stimey-mn/STM32-MetalDetector/README.md

# STM32-MetalDetector
STM32L412KB based Pulse Induction Metal Detector

Features:
* Hand solder friendly SMT parts (MCU is 0.8mm pitch LQFP, all others are SOIC and/or through hole parts.)
* STM32L4 series has 5 MSPS 12 bit ADC and ADC triggers to pulse timer
* Boost converter creates high voltage coil voltage
* Display of PI decay curve on attached OLED / LCD display
