stimey-mn/STM32-MetalDetector/Hardware/PCB_PCB_2022-12-25_MFGD_2023-04-30.png

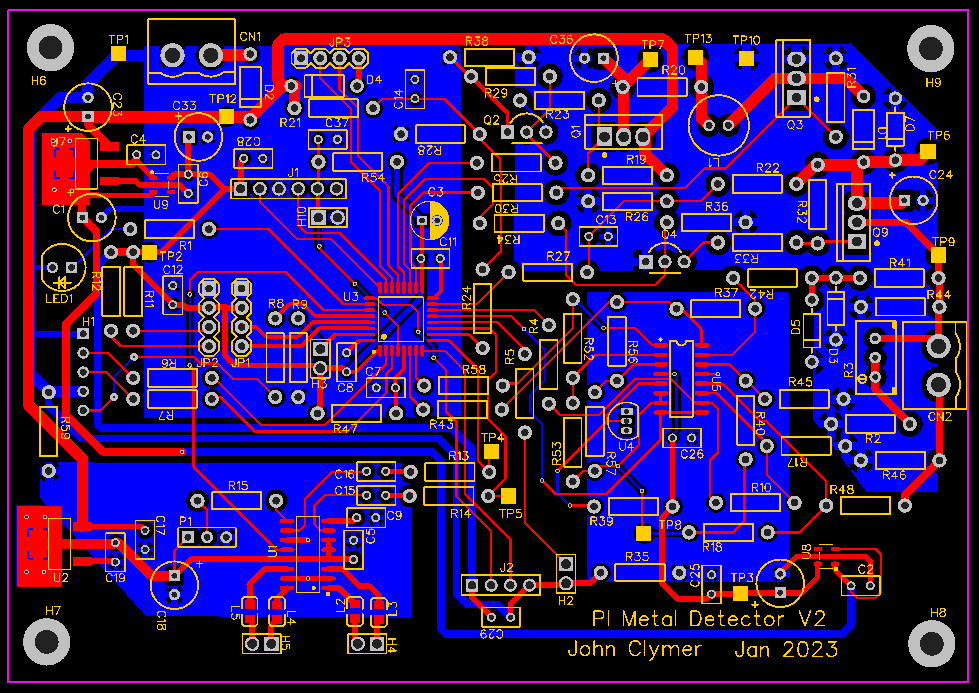
Hardware/PCB_PCB_2022-12-25_MFGD_2023-04-30.png
