stimey-mn/STM32-MetalDetector/Hardware/BOM_PI-Detector-V2_2023-04-24.xlsx

Sheet: BOM_PI-Detector-V2_2023-04-24
Designator | Value | Footprint | QTY | Supplier | Supplier PN | Cost/Ea | Cost/Total
PCB Board | NA | NA | 1 | DK Red |  | 25.00 | 25.00
U1 | PAM8406DR | SOIC-16 | 1 | Digi-Key | PAM8406DRDICT-ND | 0.85 | 0.85
U2,U7 | LDL1117S50TR | SOT-223 | 2 | Digi-Key | 497-6447-1-ND | 0.66 | 1.32
U3 | STM32L412KB | LQFP32-7x7 | 1 | Digi-Key | 497-18229-ND | 5.57 | 5.57
U4 | LM385BZ-1.2 | TO-92 | 1 | Digi-Key | LM385BZ-1.2NS/NOPB-ND | 1.10 | 1.10
U8,U9 | NCP718BSN330T1G | TSOT-223 | 2 | Digi-Key | NCP718BSN330T1GOSCT-ND | 0.60 | 1.20
U5 | TLV2375ID | SOIC-16 | 1 | Digi-Key | 296-34416-5-ND | 2.94 | 2.94
Q1 | TIP127 | TO-220 | 1 | Digi-Key | 497-2571-5-ND | 0.70 | 0.70
Q2,Q4 | PN2222ATFR | TO-92 | 2 | Digi-Key | 2368-PN2222A-ND | 0.11 | 0.22
Q3 | KSD1408 | TO-220 | 1 | Digi-Key | KSD1408YTU-ND | 1.23 | 1.23
Q9 | IRF9510PBF | TO-220 | 1 | Digi-Key | IRF9510PBF-ND | 1.11 | 1.11
OLED | SSD1309 | 2.4" OLED | 1 | Amazon |  | 16.00 | 16.00
Rot Encoder | 20 PPR | Chasis Mount | 1 | Digi-Key | PEC11L-4115F-S0020-ND | 2.89 | 2.89
Speaker | 8 Ohm | 22mm DIA | 1 | Amazon | 2104-SM230808-1-ND | 2.16 | 2.16
C15,C16 | 47nF | C-RAD-0.1 | 2 | Digi-Key | BC5153-ND | 0.16 | 0.32
C13,C26,C37 | 0.1u | C-RAD-0.1 | 3 | Digi-Key | BC1084CT-ND | 0.16 | 0.48
C2,C4,C5,C6,C7,C8,C9,C11,C12,C14,C17,C19,C28,C29 | 1u | C-RAD-0.1 | 14 | Digi-Key | 445-173261-1-ND | 0.24 | 3.36
C25 | 10u | C-RAD-0.1 | 1 | Digi-Key | 445-173132-1-ND | 0.51 | 0.51
C1, C3, C18, C23, C35, C36 | 20u | C-RAD-0.1 6.3MM DIA | 3 | Digi-Key | 565-4602-ND | 2.08 | 6.24
C24 | 47u | C-RAD-0.1 6.3MM DIA | 1 | Digi-Key | 1189-1502-ND | 0.35 | 0.35
C33 | 100uF | C-RAD-0.1 6.3MM DIA | 1 | Digi-Key | 1189-1300-ND | 0.38 | 0.38
D1,D2,D4 | 1N5819 | DO-41_BD2.4-L4.7-P8.70-D0.9-FD | 3 | Digi-Key | 497-6610-1-ND | 0.29 | 0.87
D3,D5 | 1N4148 | DO-35_BD2.0-L4.2-P8.20-D0.5-R-RD | 2 | Digi-Key | 1N4148FS-ND | 0.10 | 0.20
D7 | BZX55C47 | DO-35_BD2.0-L4.2-P8.20-D0.5-R-RD | 1 | Digi-Key | BZX55C47-TRGICT-ND | 0.23 | 0.23
H2, H3, H4, H5, H10, CN1, CN2 | CONN 2P | SIP CONN 0.1" 2 Pin | 7 | Digi-Key | S1131EC-40-ND | 0.90 | 0.90
P1 | CONN 3P | SIP CONN 0.1" 3 Pin | 1 | Digi-Key
J2, JP1, JP2, JP3 | CONN 4P | SIP CONN 0.1" 4 Pin | 4 | Digi-Key
H1 | CONN 5P | HEADER-MALE-2.54_1X5 | 1 | Digi-Key
J1 | CONN 6P | SIP CONN 0.1" 6 Pin | 1 | Digi-Key
L1 | 68uH | IND RADIAL 0.1" 2 Pin | 1 | Digi-Key | RLB0914-680KL-ND | 0.48 | 0.48
L2,L3,L4,L5 | Ferrite Bead | 805 | 4 | Digi-Key | 1934-1472-1-ND | 0.10 | 0.40
LED1 | LED-3MM | LED TH 3MM | 1 | Digi-Key | 754-1596-ND | 0.26 | 0.26
R35,R38,R47,R59 | 0 | WIRE | 4 | Digi-Key | NA | 0.00 | 0.00
R46 | 0.1 | RES TH 1/4W AXIAL | 1 | Digi-Key | WHBR10FECT-ND | 1.34 | 1.34
R20 | 1.5 | RES TH 1/4W AXIAL | 1 | Digi-Key | BC4007CT-ND | 0.32 | 0.32
R5,R6,R7,R8,R23,R32,R33 | 100 | RES TH 1/4W AXIAL | 7 | Digi-Key | RS125-KIT-ND | 40.31 | 40.31
R4 | 220 | RES TH 1/4W AXIAL | 1 | Digi-Key
R2 | 330 | RES TH 1/4W AXIAL | 1 | Digi-Key
R25,R30,R34 | 390 | RES TH 1/4W AXIAL | 3 | Digi-Key
R1,R11,R12,R24,R27, R41, R43,R58 | 1k | RES TH 1/4W AXIAL | 7 | Digi-Key
R44 | 1.2k | RES TH 1/4W AXIAL | 1 | Digi-Key
R26 | 2k | RES TH 1/4W AXIAL | 1 | Digi-Key
R3, R17,R48 | 4.7k | RES TH 1/4W AXIAL | 2 | Digi-Key
R9,R15,R19,R28,R29, R31,R36,R54 | 10k | RES TH 1/4W AXIAL | 8 | Digi-Key
R10,R18 | 16k | RES TH 1/4W AXIAL | 2 | Digi-Key
R13,R14 | 22k | RES TH 1/4W AXIAL | 2 | Digi-Key
R21,R22 | 47k | RES TH 1/4W AXIAL | 2 | Digi-Key
R39 | 100k | RES TH 1/4W AXIAL | 1 | Digi-Key
R42,R45,R53,R56 | 220k | RES TH 1/4W AXIAL | 4 | Digi-Key
R37,R40 | 470k | RES TH 1/4W AXIAL | 2 | Digi-Key
R52,R57 | 680k | RES TH 1/4W AXIAL | 2 | Digi-Key
 | 1/2" PVC PIPE |  | 1 | Ace Hardware |  | 6.00 | 6.00
 | 1 KG PLA Filament |  | 1 | Amazon | Various | 25.00 | 25.00
 | 6x32 Bolt, Nut, Washer |  | 1 | Ace Hardware | Various | 5.00 | 5.00
 | 4x40 Bolt, Nut, Washer |  | 1 | Ace Hardware | Various | 5.00 | 5.00
 |  |  |  |  |  | TOTAL | 160.24

Sheet: Sheet1
Description | Cost
PCB Board | 25.00
PAM8406DR | 0.85
LDL1117S50TR | 1.32
STM32L412KB | 5.57
LM385BZ-1.2 | 1.10
NCP718BSN330T1G | 1.20
TLV2375ID | 2.94
TIP127 | 0.70
PN2222ATFR | 0.22
KSD1408 | 1.23
IRF9510PBF | 1.11
2.4" OLED | 16.00
Knob + Encoder | 3.50
1" Speaker 8 Ohm | 2.16
Capacitors | 11.00
Zener, Schottky, LED and Silicone | 1.56
SIP Connectors | 0.90
Screw Connectors 5.08mm | 3.26
Inuductors | 0.86
Resistors | 12.00
PVC Pipe | 6.00
Filament | 25.00
Nuts & Bolts | 10.00
Total | 133.48
