stimey-mn/STM32-MetalDetector/Hardware/Schematic_PI-Detector-V2_2023-04-30.pdf

## Operator Buttons &

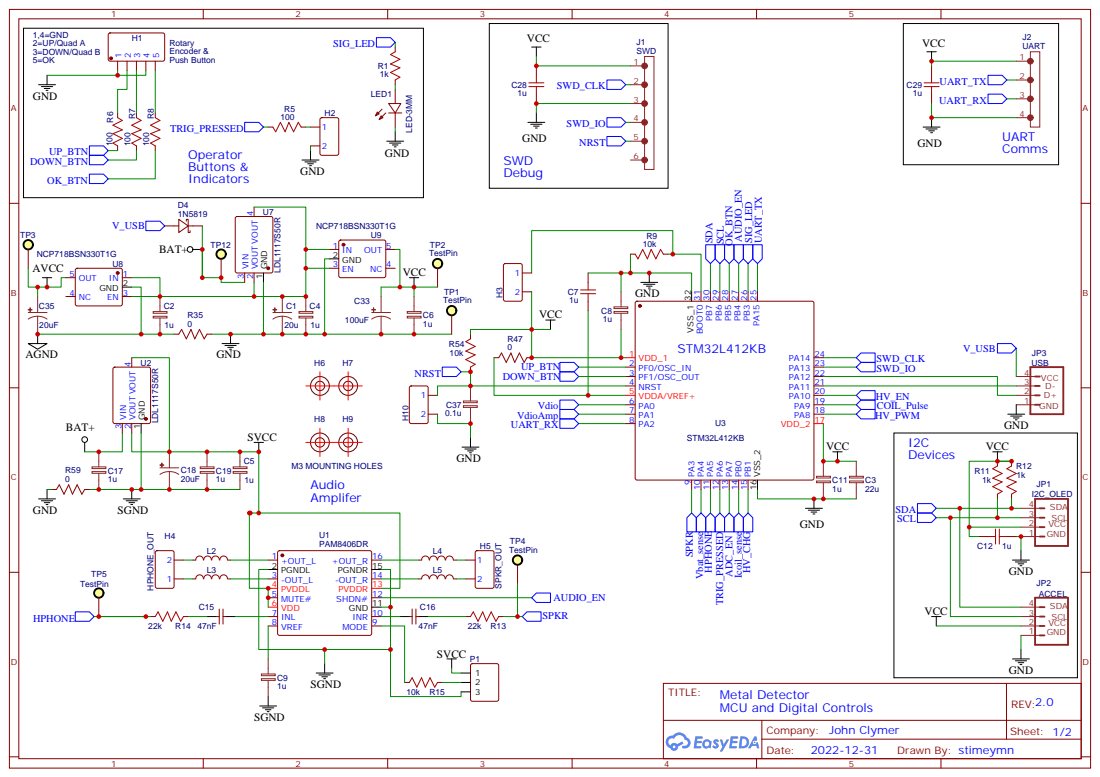
[picture p2: page 1]

## Charge Pump Voltage Multiplier

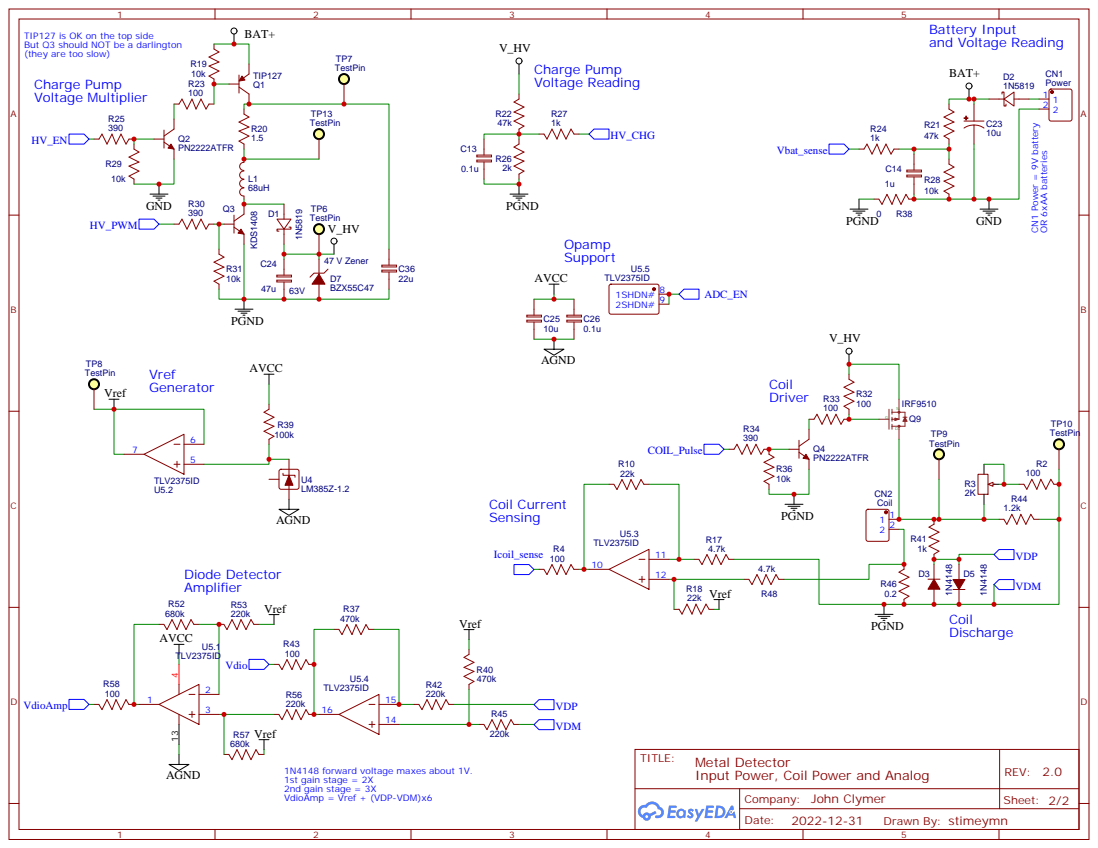
[picture p3: page 2]

TIP127 is OK on the top side
But Q3 should NOT be a darlington
(they are too slow)

1N4148 forward voltage maxes about 1V.
1st gain stage = 2X
2nd gain stage = 3X
VdioAmp = Vref + (VDP-VDM)x6

Input Power, Coil Power and Analog
