stimey-mn/STM32-MetalDetector/Firmware/MetalDetector-Cube-412/Src/click.c

#include "click.h"

const unsigned char UtopiaOpen_raw[] = {
  0x80, 0x80, 0x7f, 0x7f, 0x7f, 0x7f, 0x7f, 0x7f, 0x7f, 0x7f, 0x80, 0x7f,
  0x7f, 0x7f, 0x7f, 0x7e, 0x7e, 0x7f, 0x7f, 0x7e, 0x7e, 0x7f, 0x7e, 0x7d,
  0x7d, 0x7f, 0x81, 0x82, 0x81, 0x80, 0x80, 0x82, 0x83, 0x82, 0x82, 0x81,
  0x7f, 0x7d, 0x7d, 0x7e, 0x7e, 0x7e, 0x80, 0x83, 0x83, 0x80, 0x7e, 0x7e,
  0x81, 0x83, 0x81, 0x7f, 0x7e, 0x7d, 0x7d, 0x7e, 0x81, 0x83, 0x81, 0x7e,
  0x7e, 0x81, 0x83, 0x81, 0x7e, 0x7e, 0x81, 0x83, 0x82, 0x80, 0x80, 0x80,
  0x82, 0x83, 0x82, 0x80, 0x7f, 0x7f, 0x80, 0x81, 0x81, 0x81, 0x81, 0x82,
  0x83, 0x82, 0x80, 0x7f, 0x7f, 0x80, 0x82, 0x83, 0x82, 0x82, 0x82, 0x83,
  0x81, 0x7f, 0x7d, 0x7d, 0x7f, 0x80, 0x80, 0x81, 0x82, 0x83, 0x81, 0x7e,
  0x7d, 0x7f, 0x81, 0x82, 0x81, 0x80, 0x80, 0x82, 0x83, 0x82, 0x80, 0x80,
  0x81, 0x82, 0x82, 0x82, 0x81, 0x7f, 0x7d, 0x7e, 0x81, 0x83, 0x82, 0x80,
  0x80, 0x81, 0x82, 0x81, 0x7e, 0x7e, 0x80, 0x83, 0x83, 0x82, 0x82, 0x82,
  0x82, 0x82, 0x82, 0x82, 0x82, 0x82, 0x82, 0x82, 0x82, 0x82, 0x82, 0x82,
  0x82, 0x82, 0x82, 0x82, 0x82, 0x82, 0x82, 0x82, 0x82, 0x82, 0x82, 0x82,
  0x82, 0x82, 0x82, 0x82, 0x82, 0x82, 0x82, 0x82, 0x82, 0x81, 0x80, 0x7f,
  0x7f, 0x81, 0x83, 0x81, 0x7e, 0x7e, 0x81, 0x83, 0x83, 0x80, 0x7e, 0x7f,
  0x80, 0x82, 0x83, 0x82, 0x81, 0x7e, 0x7e, 0x81, 0x83, 0x82, 0x7e, 0x7d,
  0x7f, 0x81, 0x82, 0x82, 0x83, 0x83, 0x80, 0x7b, 0x7a, 0x80, 0x84, 0x81,
  0x7a, 0x7a, 0x80, 0x86, 0x85, 0x82, 0x83, 0x83, 0x7d, 0x77, 0x7b, 0x84,
  0x85, 0x7a, 0x77, 0x86, 0x97, 0x91, 0x7a, 0x6e, 0x7b, 0x8c, 0x87, 0x74,
  0x70, 0x81, 0x92, 0x8e, 0x7f, 0x79, 0x7f, 0x85, 0x83, 0x80, 0x82, 0x84,
  0x81, 0x7e, 0x7e, 0x81, 0x82, 0x80, 0x7f, 0x7f, 0x7e, 0x7e, 0x7f, 0x81,
  0x80, 0x7e, 0x7d, 0x7f, 0x80, 0x7f, 0x7d, 0x7e, 0x81, 0x83, 0x82, 0x81,
  0x82, 0x83, 0x82, 0x82, 0x82, 0x82, 0x82, 0x82, 0x82, 0x83, 0x81, 0x7e,
  0x7d, 0x7d, 0x7e, 0x7d, 0x7d, 0x7e, 0x81, 0x83, 0x81, 0x7e, 0x7d, 0x7e,
  0x7e, 0x7d, 0x7d, 0x7f, 0x81, 0x81, 0x7f, 0x7d, 0x7e, 0x80, 0x80, 0x7d,
  0x7c, 0x7f, 0x81, 0x81, 0x80, 0x80, 0x82, 0x83, 0x81, 0x7d, 0x7b, 0x7c,
  0x7d, 0x7f, 0x81, 0x81, 0x7f, 0x7d, 0x7d, 0x7e, 0x7e, 0x7e, 0x7d, 0x7d,
  0x7f, 0x81, 0x82, 0x81, 0x80, 0x7f, 0x80, 0x80, 0x7f, 0x7e, 0x7d, 0x7d,
  0x7e, 0x7e, 0x7d, 0x7d, 0x7e, 0x7f, 0x7f, 0x80, 0x80, 0x80, 0x7f, 0x7e,
  0x7e, 0x7e, 0x7d, 0x7d, 0x7e, 0x7f, 0x81, 0x81, 0x80, 0x7d, 0x7c, 0x7d,
  0x7f, 0x81, 0x81, 0x7f, 0x7d, 0x7d, 0x7d, 0x7e, 0x7e, 0x7d, 0x7d, 0x7f,
  0x81, 0x82, 0x82, 0x82, 0x82, 0x82, 0x82, 0x81, 0x7f, 0x7d, 0x7d, 0x7e,
  0x7f, 0x81, 0x82, 0x83, 0x82, 0x81, 0x82, 0x83, 0x81, 0x7e, 0x7d, 0x7e,
  0x81, 0x83, 0x81, 0x7f, 0x7e, 0x7f, 0x7f, 0x7e, 0x7d, 0x7d, 0x7f, 0x81,
  0x82, 0x82, 0x82, 0x82, 0x82, 0x81, 0x7f, 0x7e, 0x7d, 0x7d, 0x7f, 0x81,
  0x82, 0x81, 0x7f, 0x7d, 0x7d, 0x7e, 0x7e, 0x7d, 0x7e, 0x7f, 0x80, 0x7f,
  0x7f, 0x80, 0x82, 0x82, 0x7f, 0x7b, 0x7b, 0x7d, 0x7e, 0x7e, 0x7c, 0x7b,
  0x7c, 0x7e, 0x7e, 0x7c, 0x7b, 0x7c, 0x7d, 0x7e, 0x7e, 0x7d, 0x7d, 0x7e,
  0x7e, 0x7d, 0x7d, 0x7e, 0x7e, 0x7d, 0x7d, 0x7e, 0x7e, 0x7e, 0x7c, 0x7b,
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
};
const unsigned int UtopiaOpen_raw_len = 4330;
