stimey-mn/STM32-MetalDetector/Firmware/MetalDetector-Cube-412/Inc/click.h

/*
 * click.h
 *
 *  Created on: Jul 9, 2019
 *      Author: stimey
 */

#ifndef CLICK_H_
#define CLICK_H_

extern const unsigned char UtopiaOpen_raw[] ;
extern const unsigned int UtopiaOpen_raw_len;

#endif /* CLICK_H_ */
