stimey-mn/STM32-MetalDetector/(commit log)

2023-04-30 Added schematics, PCB and PNG
    Added schematics, PCB Gerber files and a PNG of the board layers.
2023-04-30 BOM
    ROUGH Bom
    [BOM_PI-Detector-V2_2023-04-24.xlsx]
2023-05-07 Update FIRMWARE-README
    Correction on statement of no library being used. Referred to CUBE-IDE instead of STM32 HAL.
